miyazaki1114/.history/radundant_circuit.kicad_pcb

## KiCad design radundant_circuit.kicad_pcb (2026-10-21)

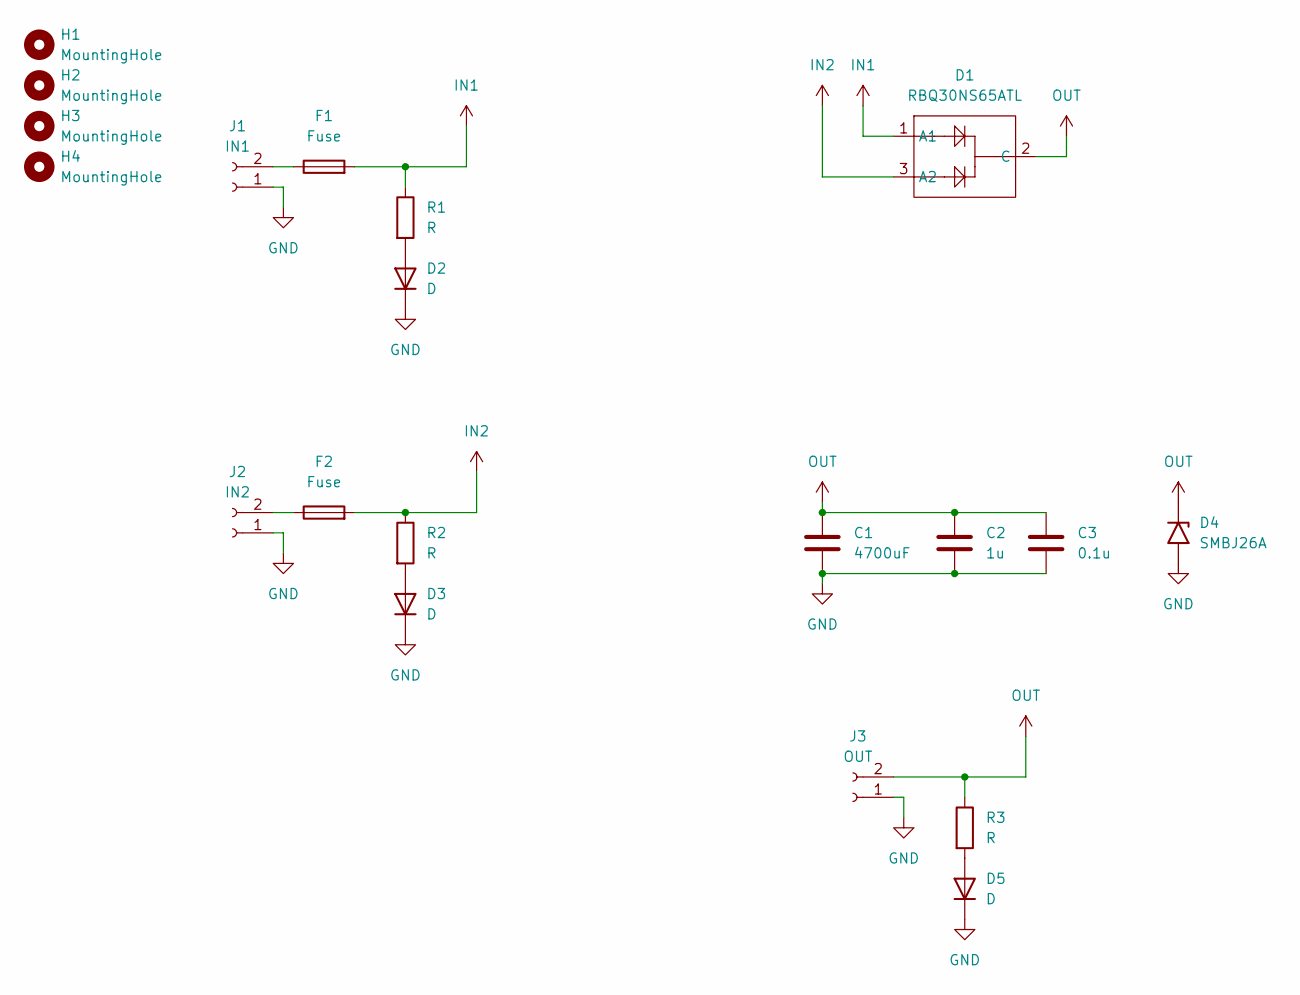
[picture p2: schematic radundant_circuit.kicad_sch]

Parts:
C1: 4700uF; CP_Radial_D18.0mm_P7.50mm
C2: 1u; C_0603_1608Metric_Pad1.08x0.95mm_HandSolder
C3: 0.1u; C_0603_1608Metric_Pad1.08x0.95mm_HandSolder
D1: RBQ30NS65ATL; TO-263-2
D2, D3, D5: D; LED_0603_1608Metric_Pad1.05x0.95mm_HandSolder
D4: SMBJ26A; D_SMB
F1, F2: Fuse; FUSE_SOCKET
H1, H2, H3, H4: MountingHole; MountingHole_3.2mm_M3
J1: IN1; AMASS_XT60-F_1x02_P7.20mm_Vertical
J2: IN2; AMASS_XT60-F_1x02_P7.20mm_Vertical
J3: OUT; AMASS_XT60-F_1x02_P7.20mm_Vertical
R1, R2, R3: R; R_0603_1608Metric_Pad0.98x0.95mm_HandSolder

Connections:
GND: C1.2, C2.2, C3.2, D2.1 (K), D3.1 (K), D4.2 (A2), D5.1 (K), J1.1, J2.1, J3.1
IN1: D1.1 (A1), F1.2, R1.1
IN2: D1.3 (A2), F2.2, R2.1
unnamed: D2.2 (A), R1.2
unnamed: D3.2 (A), R2.2
unnamed: D5.2 (A), R3.2
unnamed: F1.1, J1.2
unnamed: F2.1, J2.2
OUT: C1.1, C2.1, C3.1, D1.2 (C), D4.1 (A1), J3.2, R3.1

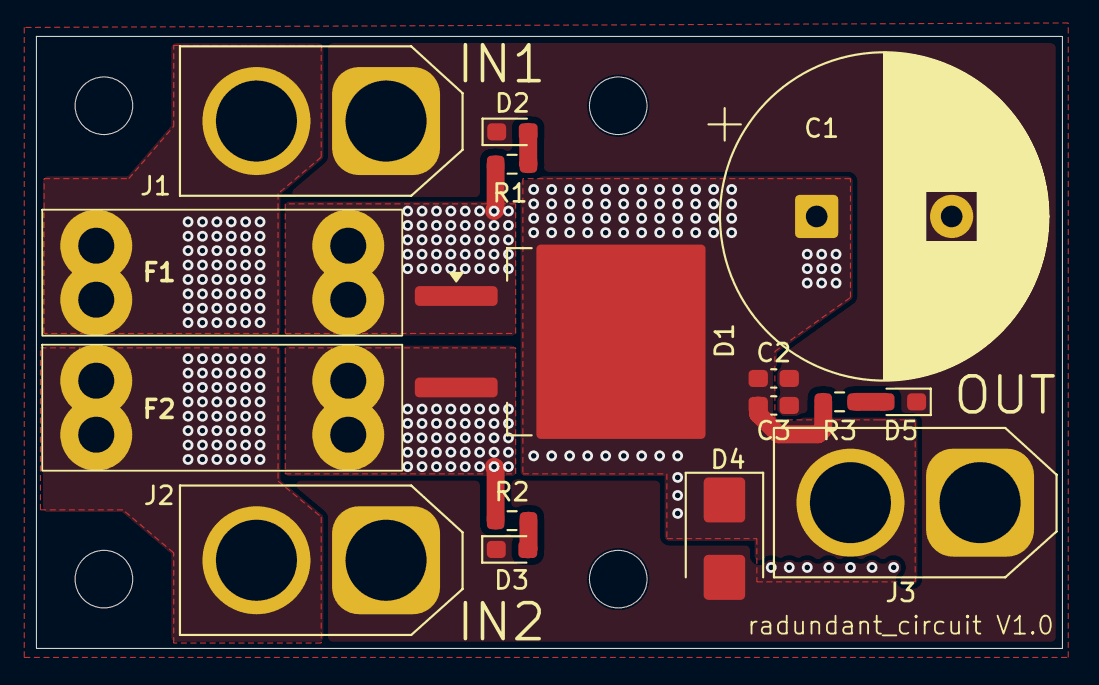
[picture p3: board radundant_circuit.kicad_pcb from above]

Board: 2 copper layers, 57.0 x 34.0 mm, 20 parts (0 on the bottom side), 9 nets.
