miyazaki1114/.history/(commit log)

2026-10-20 SCH Save
    [radundant_circuit.kicad_sch]
2026-10-20 PCB Save
    [radundant_circuit.kicad_pcb]
2026-10-21 git修正
2026-10-21 コミット
2026-10-21 README.mdを追加し、冗長電源基板の設計情報と使用方法を記載
